domw95/UESB/README.md

# UESB
## Ultimate ESC Switcher Board.

A device to control up to 6 brushed DC motors from 2 radio control input signals. The firmware is configued to drive 1 motor at a time via 1 input signal, and switch between based on the other.

[More details](https://domwil.co.uk/posts/uesb/)
