domw95/UESB/Hardware/RC-DC-Motor_Splitter/3D/RC-DC-Motor_Splitter.step

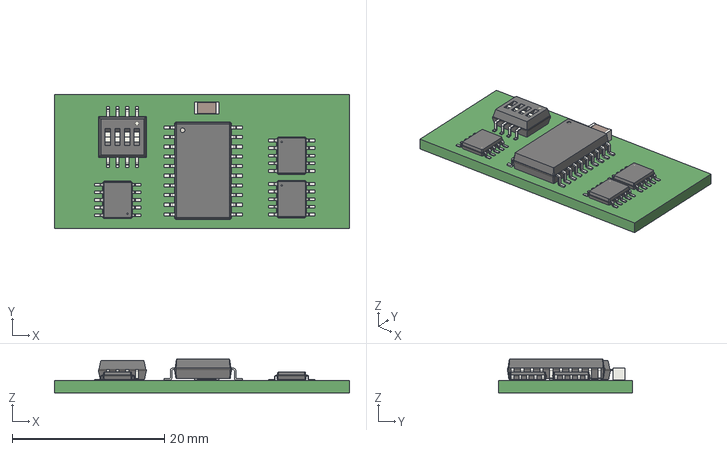
[picture p1: CAD file, 2021-01-23]
Hardware/RC-DC-Motor_Splitter/3D/RC-DC-Motor_Splitter.step
38.7 x 17.7 x 4.40 mm
