domw95/UESB/Hardware/RC-DC-Motor_Splitter/RC-DC-Motor_Splitter.pdf

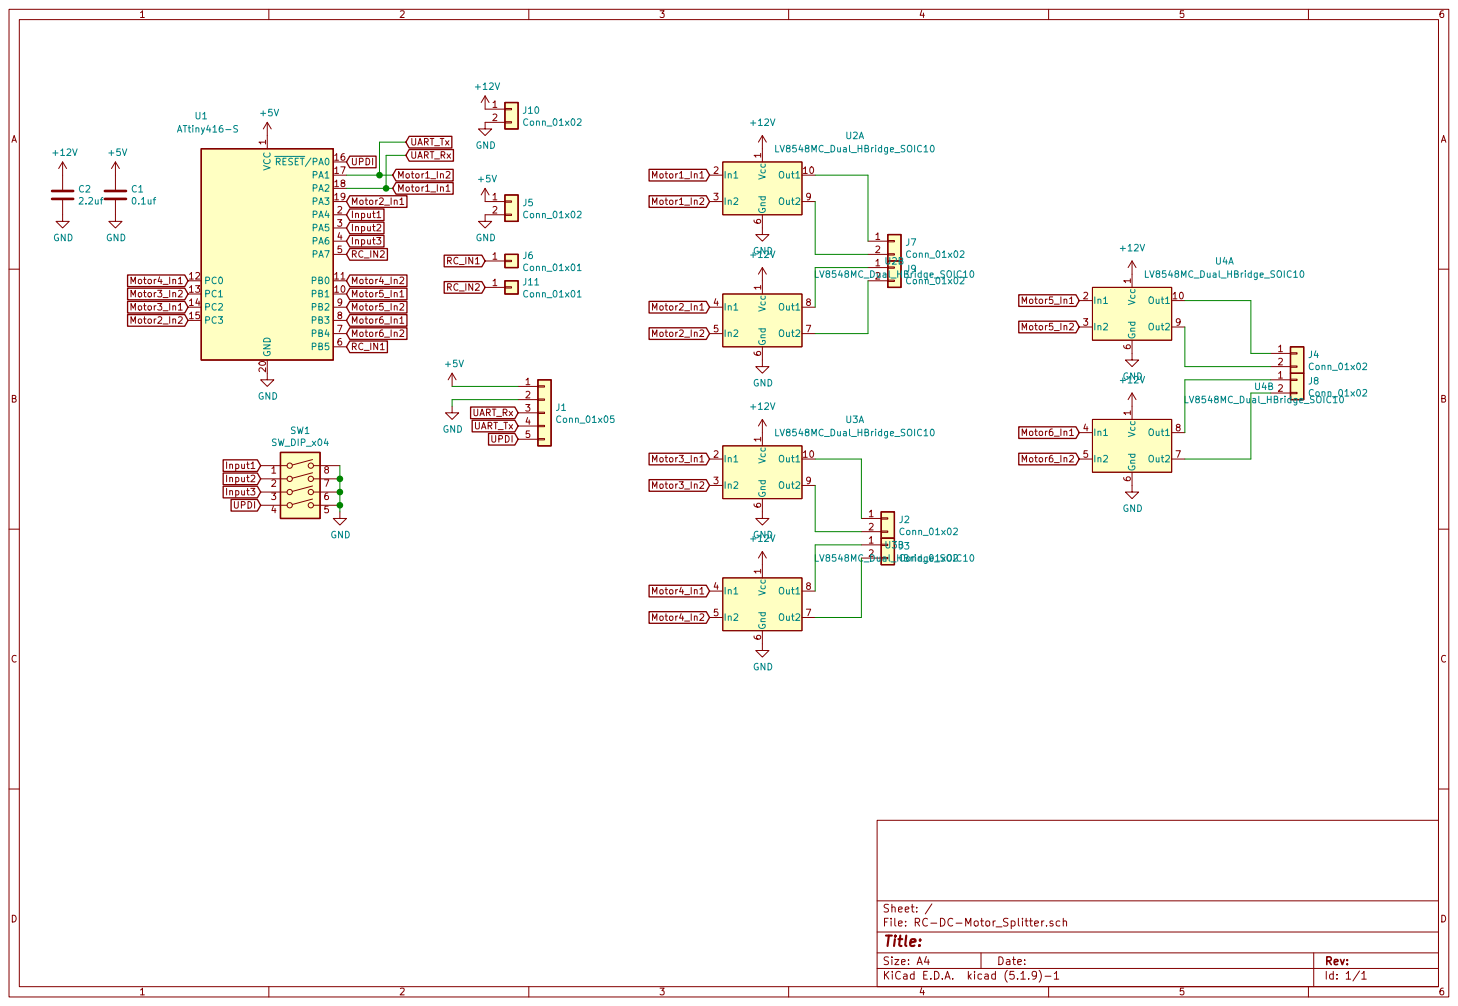
[picture p2: page 1]

File: RC-DC-Motor_Splitter.sch Sheet: /
Id: 1/1 Title:
