domw95/UESB/Hardware/RC-DC-Motor_Splitter/RC-DC-Motor_Splitter.kicad_pcb

## KiCad design Hardware/RC-DC-Motor_Splitter/RC-DC-Motor_Splitter.kicad_pcb (2021-01-25)

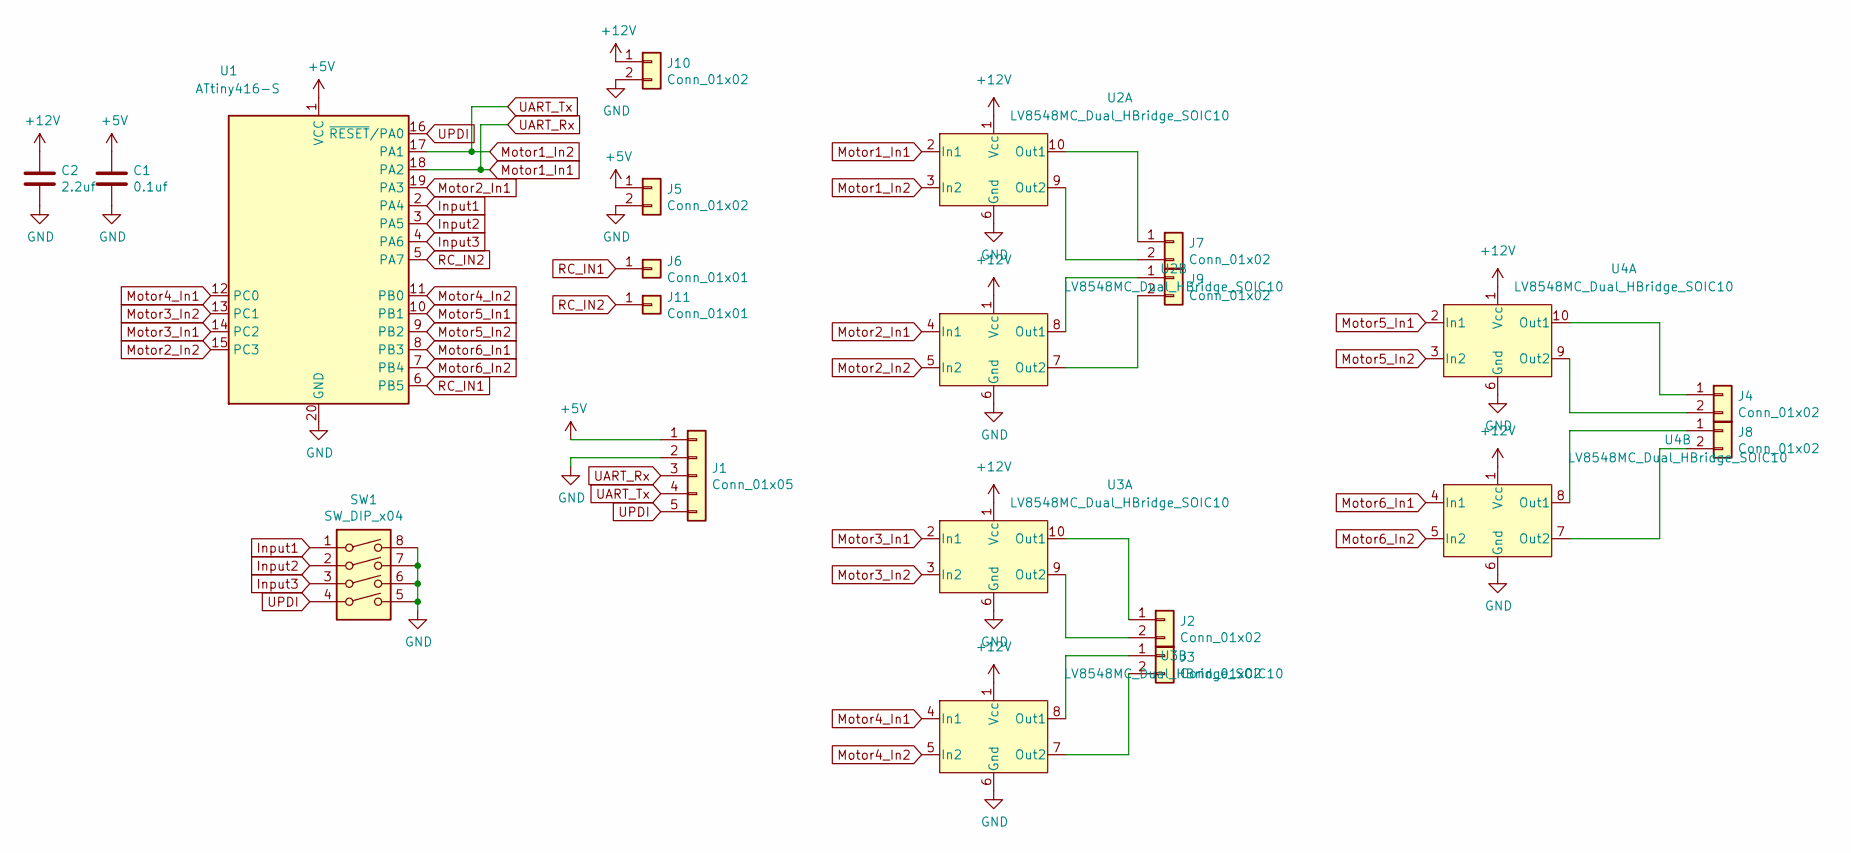
[picture p3: schematic RC-DC-Motor_Splitter.sch]

Parts:
C1: 0.1uf; C_1206_3216Metric_Pad1.33x1.80mm_HandSolder
C2: 2.2uf; C_1206_3216Metric_Pad1.33x1.80mm_HandSolder
J1: Conn_01x05; PinHeader_1x05_P2.54mm_Vertical
J2, J3, J4, J5, J7, J8, J9, J10: Conn_01x02; Motor_Pad
J6, J11: Conn_01x01; Single_Pad
SW1: SW_DIP_x04; SOIC-8-Extended_pads_dip-switch; LCSC C132838
U1: ATtiny416-S; SOIC-20W_7.5x12.8mm_P1.27mm; LCSC C145622
U2, U3, U4: LV8548MC_Dual_HBridge_SOIC10; SOIC-10_3.9x4.9mm_P1.00mm; LCSC C19950

Connections:
+5V: C1.1, J1.1, J5.1, U1.1 (VCC)
+12V: C2.1, J10.1, U2.1 (Vcc), U3.1 (Vcc), U4.1 (Vcc)
GND: C1.2, C2.2, J1.2, J5.2, J10.2, SW1.5, SW1.6, SW1.7, SW1.8, U1.20 (GND), U2.6 (Gnd), U3.6 (Gnd), U4.6 (Gnd)
Input1: SW1.1, U1.2 (PA4)
Input2: SW1.2, U1.3 (PA5)
Input3: SW1.3, U1.4 (PA6)
Motor1_In1: J1.3, U1.18 (PA2), U2.2 (In1)
Motor1_In2: J1.4, U1.17 (PA1), U2.3 (In2)
Motor2_In1: U1.19 (PA3), U2.4 (In1)
Motor2_In2: U1.15 (PC3), U2.5 (In2)
Motor3_In1: U1.14 (PC2), U3.2 (In1)
Motor3_In2: U1.13 (PC1), U3.3 (In2)
Motor4_In1: U1.12 (PC0), U3.4 (In1)
Motor4_In2: U1.11 (PB0), U3.5 (In2)
Motor5_In1: U1.10 (PB1), U4.2 (In1)
Motor5_In2: U1.9 (PB2), U4.3 (In2)
Motor6_In1: U1.8 (PB3), U4.4 (In1)
Motor6_In2: U1.7 (PB4), U4.5 (In2)
unnamed: J2.1, U3.10 (Out1)
unnamed: J2.2, U3.9 (Out2)
unnamed: J3.1, U3.8 (Out1)
unnamed: J3.2, U3.7 (Out2)
unnamed: J4.1, U4.10 (Out1)
unnamed: J4.2, U4.9 (Out2)
unnamed: J7.1, U2.10 (Out1)
unnamed: J7.2, U2.9 (Out2)
unnamed: J8.1, U4.8 (Out1)
unnamed: J8.2, U4.7 (Out2)
unnamed: J9.1, U2.8 (Out1)
unnamed: J9.2, U2.7 (Out2)
RC_IN1: J6.1, U1.6 (PB5)
RC_IN2: J11.1, U1.5 (PA7)
UPDI: J1.5, SW1.4, U1.16 (~RESET~/PA0)

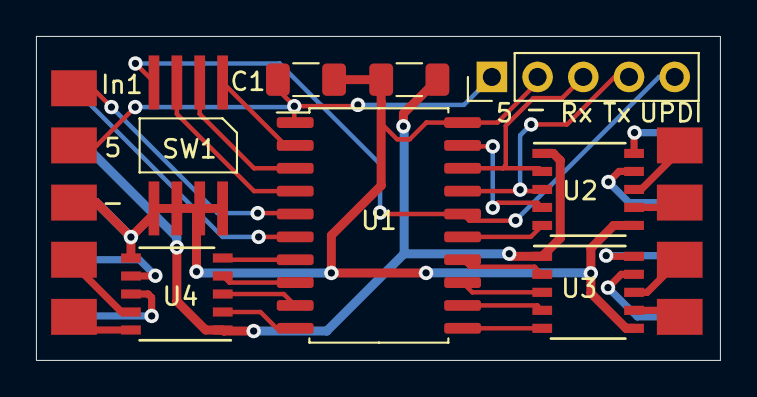
[picture p4: board RC-DC-Motor_Splitter.kicad_pcb from above]

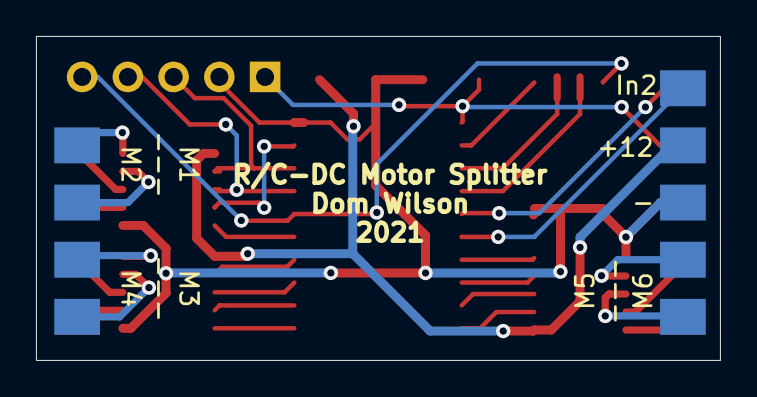
[picture p5: board RC-DC-Motor_Splitter.kicad_pcb from below]

Board: 2 copper layers, 38.0 x 18.0 mm, 18 parts (5 on the bottom side), 33 nets.
