domw95/UESB/(commit log)

2021-01-23 Created KiCad Project
    [RC-DC-Motor_Splitter.kicad_pcb, RC-DC-Motor_Splitter.sch]
2021-01-23 New Small Design
    [RC-DC-Motor_Splitter-B_Cu.gbr, RC-DC-Motor_Splitter-B_Mask.gbr, RC-DC-Motor_Splitter-B_Paste.gbr, RC-DC-Motor_Splitter-B_SilkS.gbr, RC-DC-Motor_Splitter-Edge_Cuts.gbr, RC-DC-Motor_Splitter-F_Cu.gbr, RC-DC-Motor_Splitter-F_Mask.gbr, RC-DC-Motor_Splitter-F_Paste.gbr]
2021-01-23 Added pdf schematic
2021-01-25 Production Design
    [RC-DC-Motor_Splitter-B_Cu.gbr, RC-DC-Motor_Splitter-B_Mask.gbr, RC-DC-Motor_Splitter-B_Paste.gbr, RC-DC-Motor_Splitter-B_SilkS.gbr, RC-DC-Motor_Splitter-Edge_Cuts.gbr, RC-DC-Motor_Splitter-F_Cu.gbr, RC-DC-Motor_Splitter-F_Mask.gbr, RC-DC-Motor_Splitter-F_Paste.gbr]
